AdamAntoshin/SAP-1.5/Schematics/WhatsApp Image 2019-12-20 at 13.47.41.jpeg

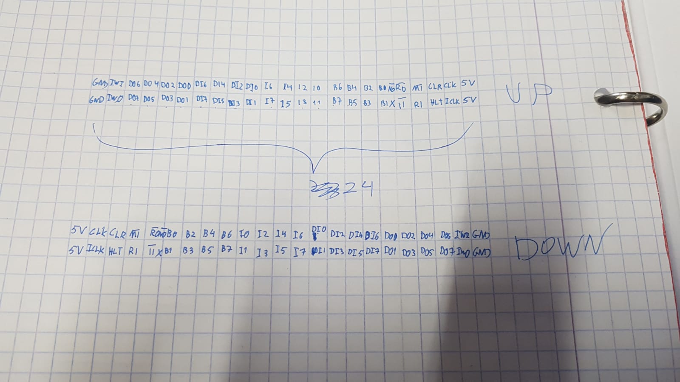
Schematics/WhatsApp Image 2019-12-20 at 13.47.41.jpeg
