AdamAntoshin/SAP-1.5/Documentation/Images/board1_back.jpeg

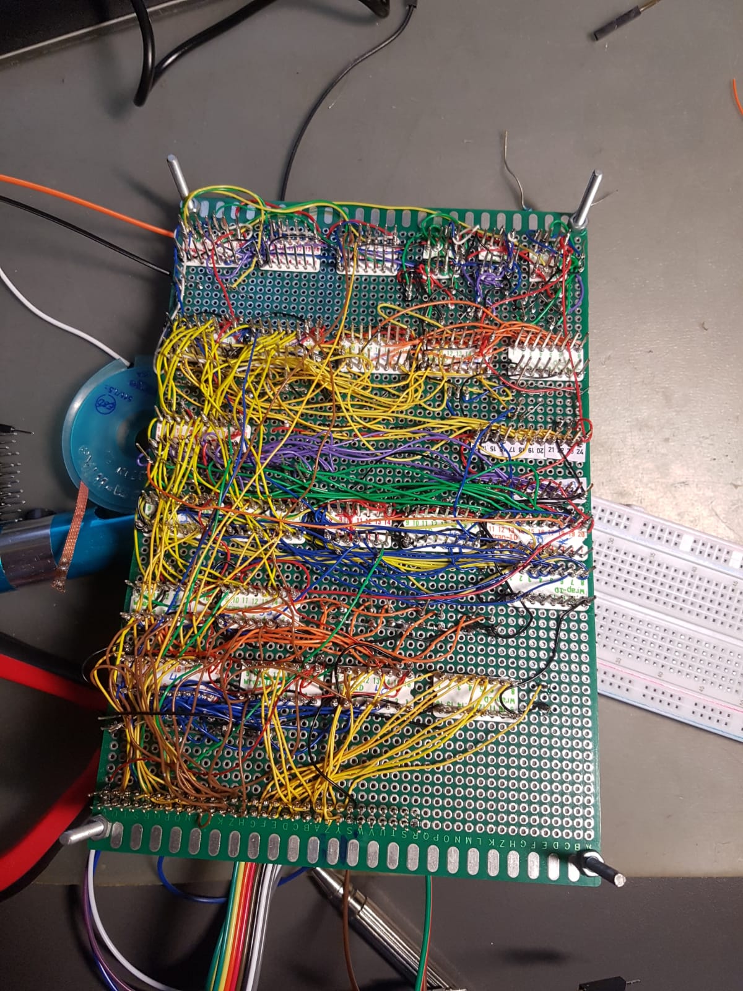
Documentation/Images/board1_back.jpeg
