AdamAntoshin/SAP-1.5/Documentation/Images/board1_front.jpeg

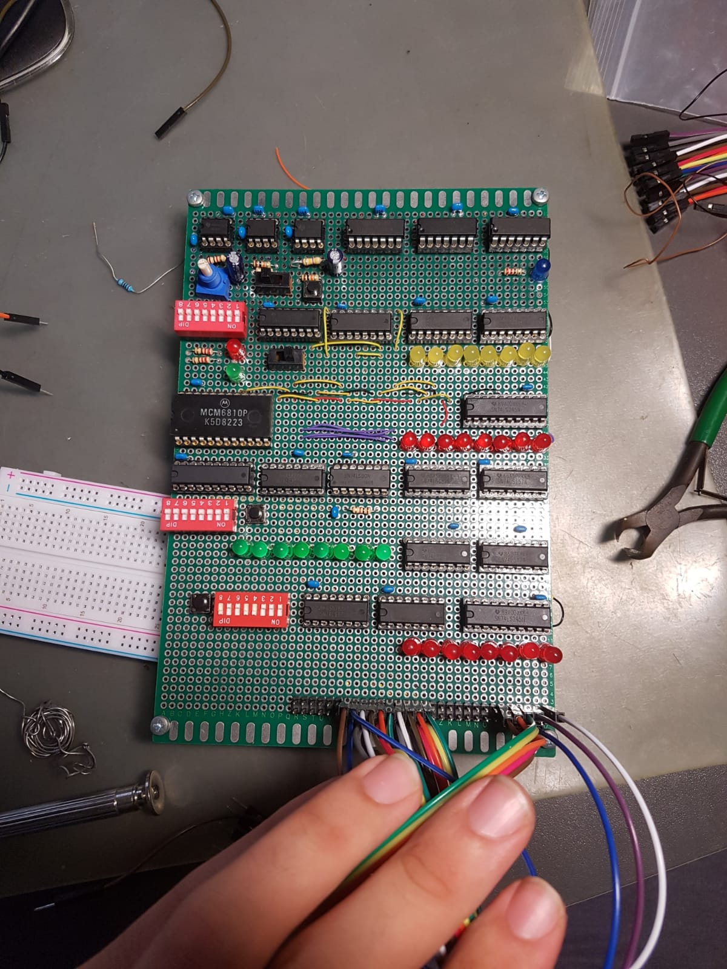
Documentation/Images/board1_front.jpeg
