AdamAntoshin/SAP-1.5/Documentation/Images/board2_back.jpeg

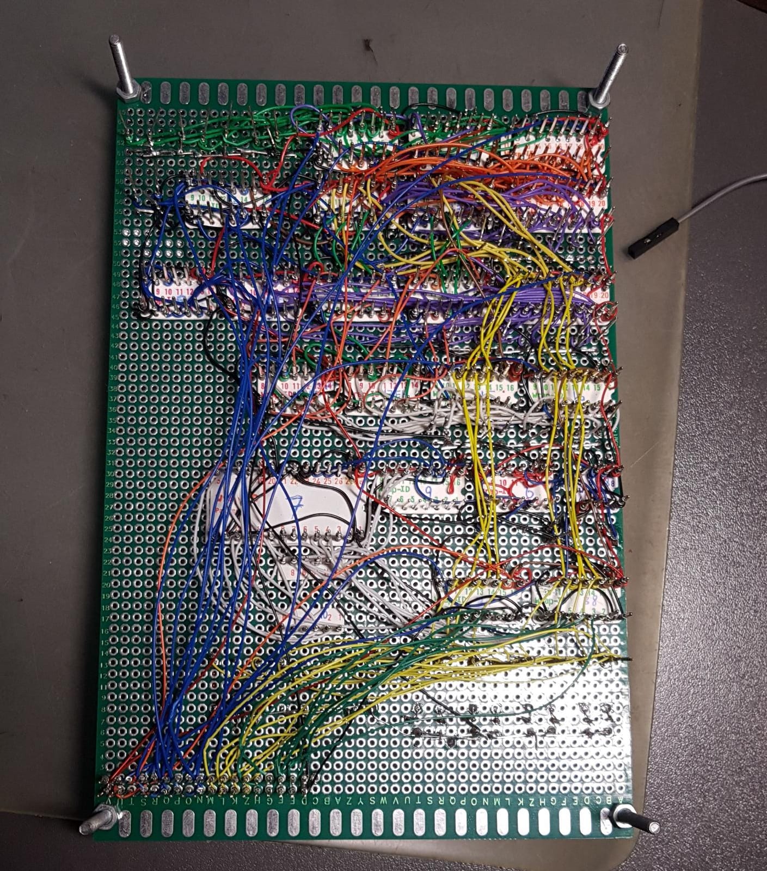
Documentation/Images/board2_back.jpeg
