AdamAntoshin/SAP-1.5/Documentation/Images/board2_front.jpeg

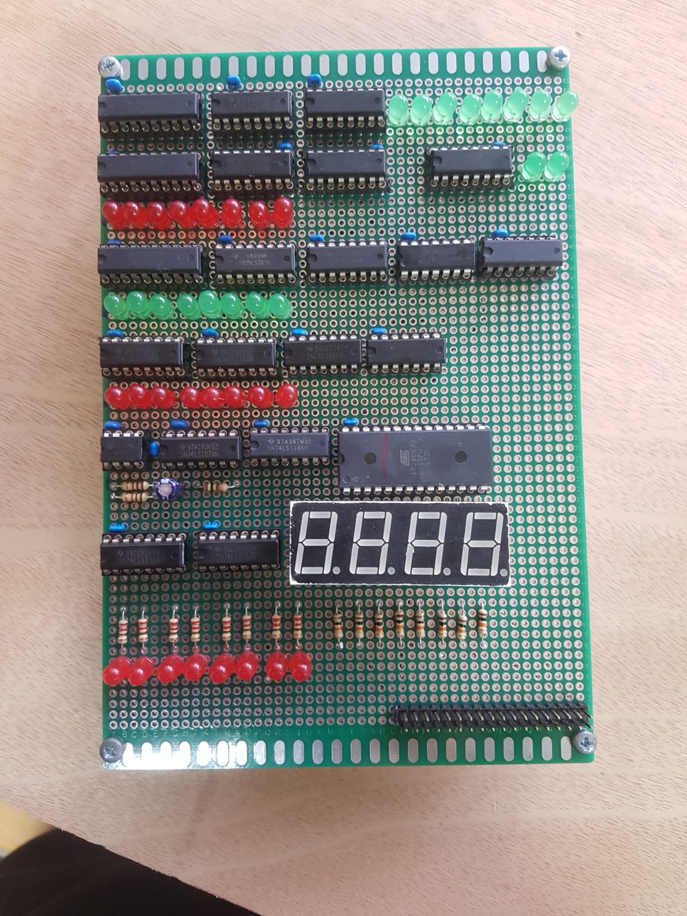
Documentation/Images/board2_front.jpeg
