AdamAntoshin/SAP-1.5/Documentation/Images/board3_back.jpeg

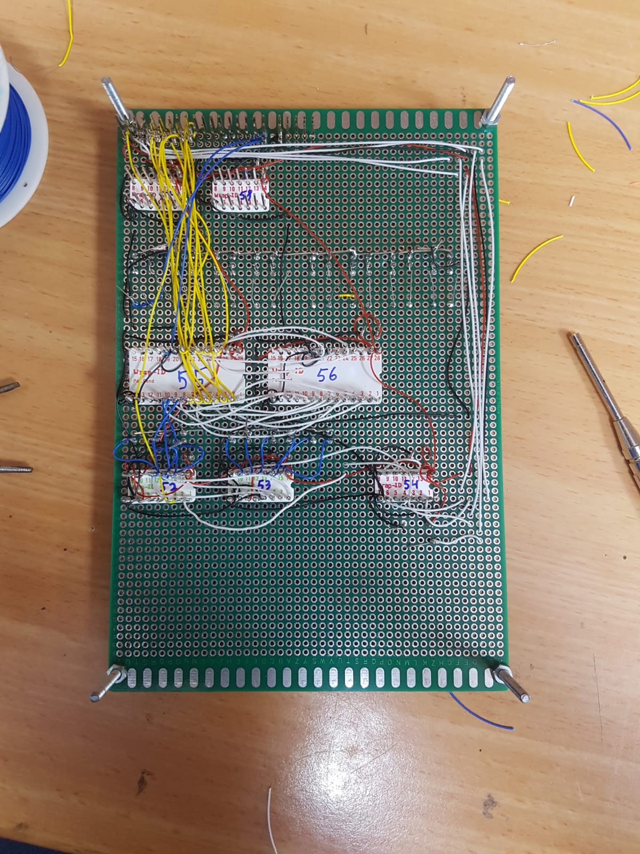
Documentation/Images/board3_back.jpeg
