AdamAntoshin/SAP-1.5/Documentation/Images/board3_front.jpeg

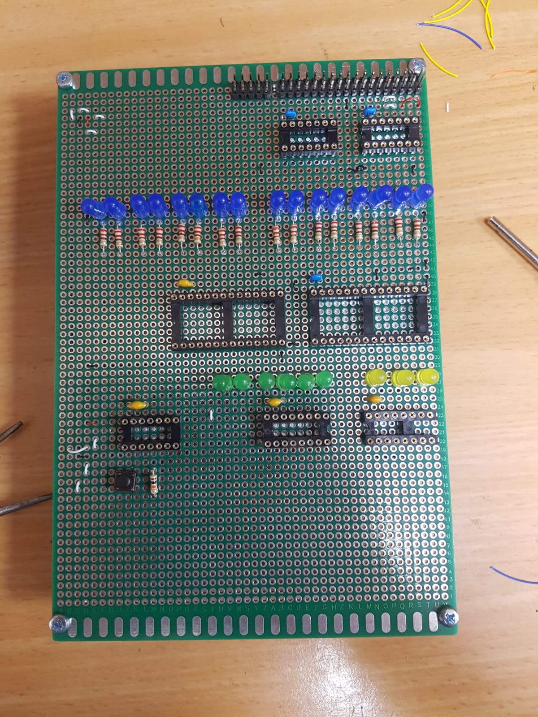
Documentation/Images/board3_front.jpeg
