AdamAntoshin/SAP-1.5/Schematics/EEPROM Programmer.pdf

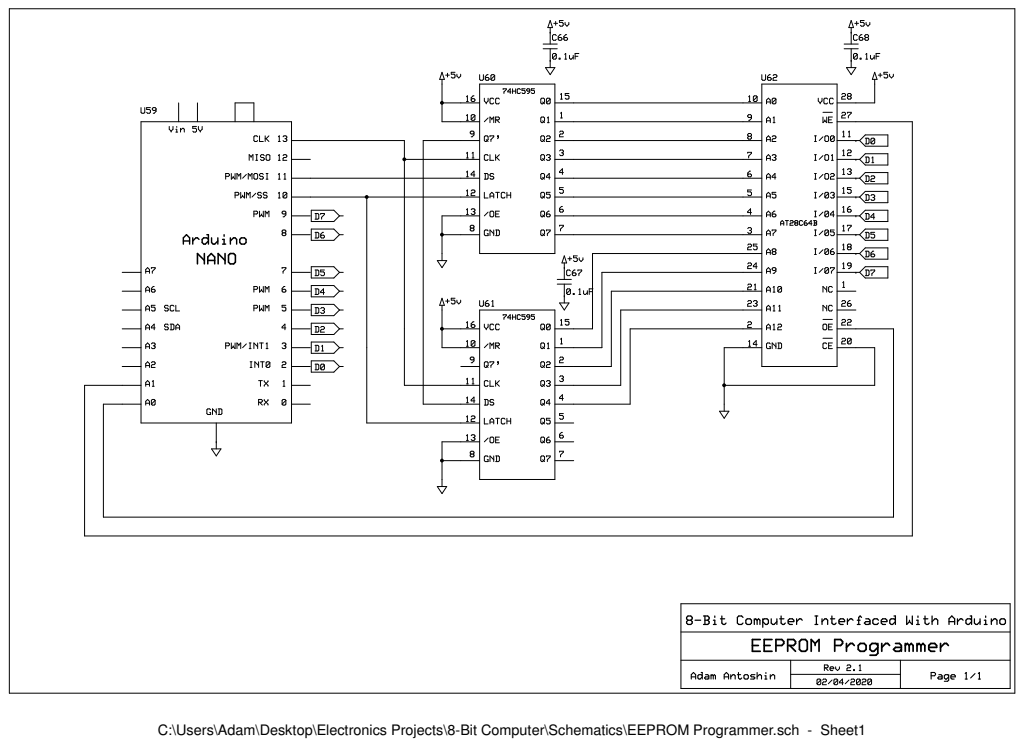
[picture p9: page 1]

C:\Users\Adam\Desktop\Electronics Projects\8-Bit Computer\Schematics\EEPROM Programmer.sch - Sheet1
