AdamAntoshin/SAP-1.5/Schematics/Arduino Driver.pdf

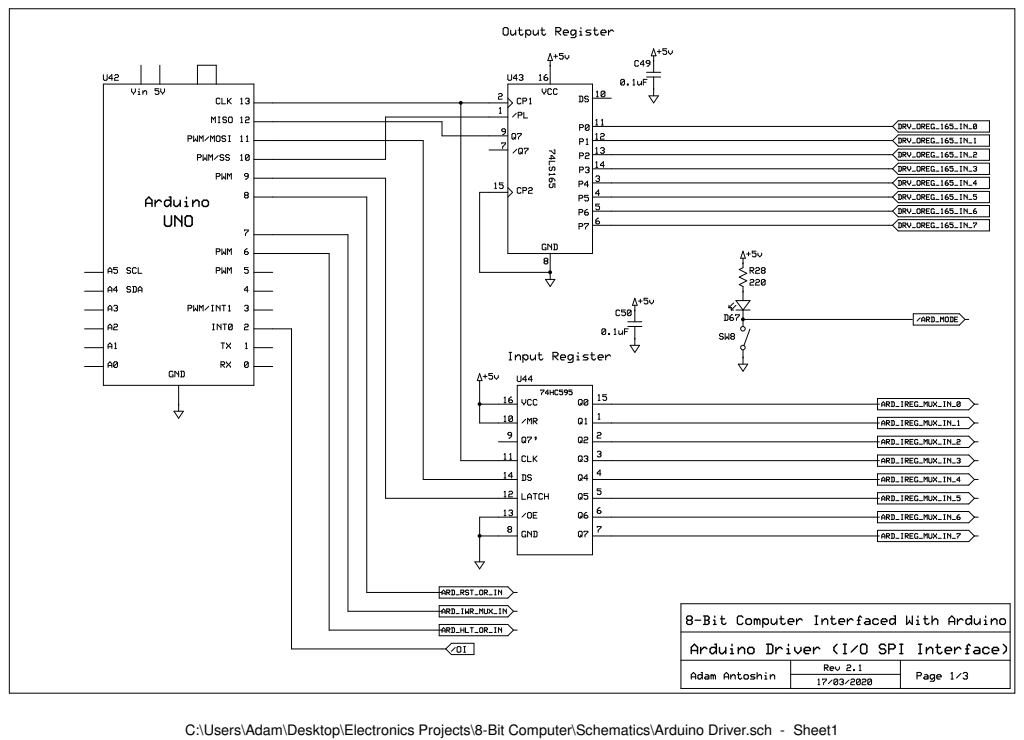
[picture p10: page 1]

C:\Users\Adam\Desktop\Electronics Projects\8-Bit Computer\Schematics\Arduino Driver.sch - Sheet1

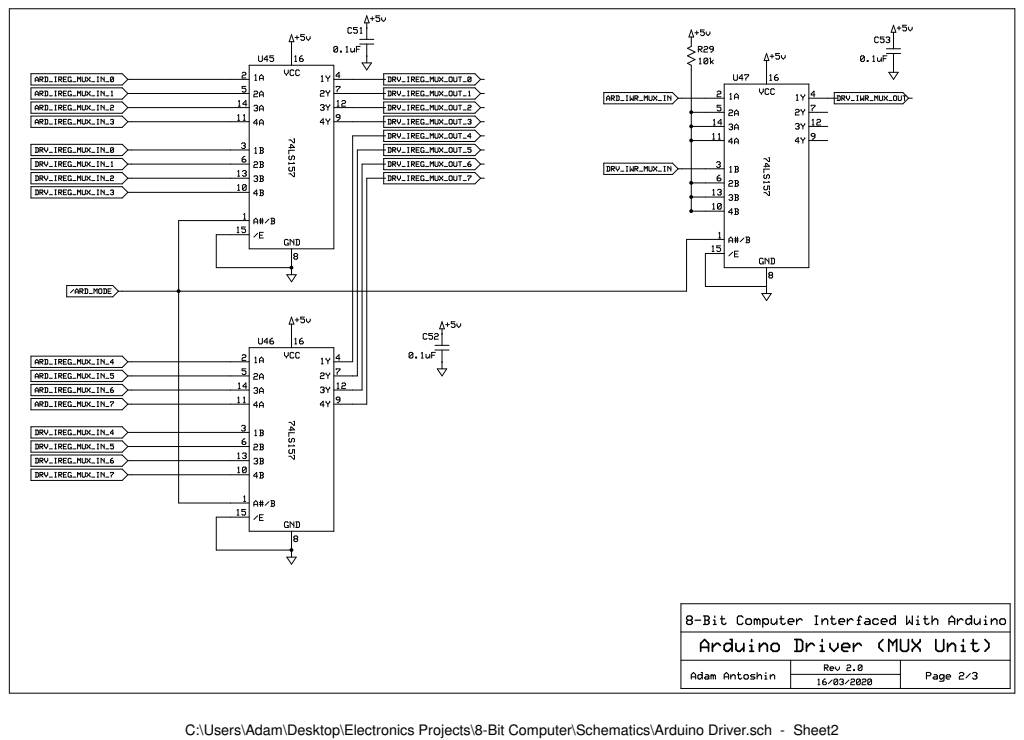
[picture p11: page 2]

C:\Users\Adam\Desktop\Electronics Projects\8-Bit Computer\Schematics\Arduino Driver.sch - Sheet2

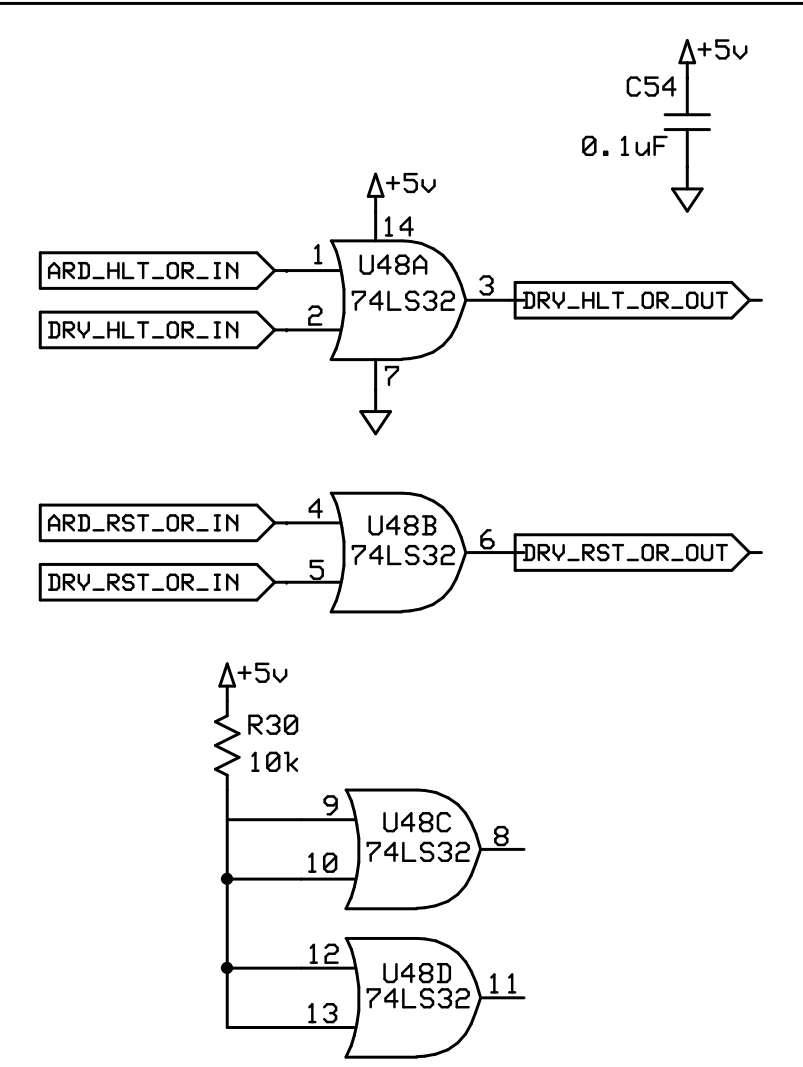
[picture p12: page 3]

C:\Users\Adam\Desktop\Electronics Projects\8-Bit Computer\Schematics\Arduino Driver.sch - Sheet3
