AdamAntoshin/SAP-1.5/Schematics/Ports.pdf

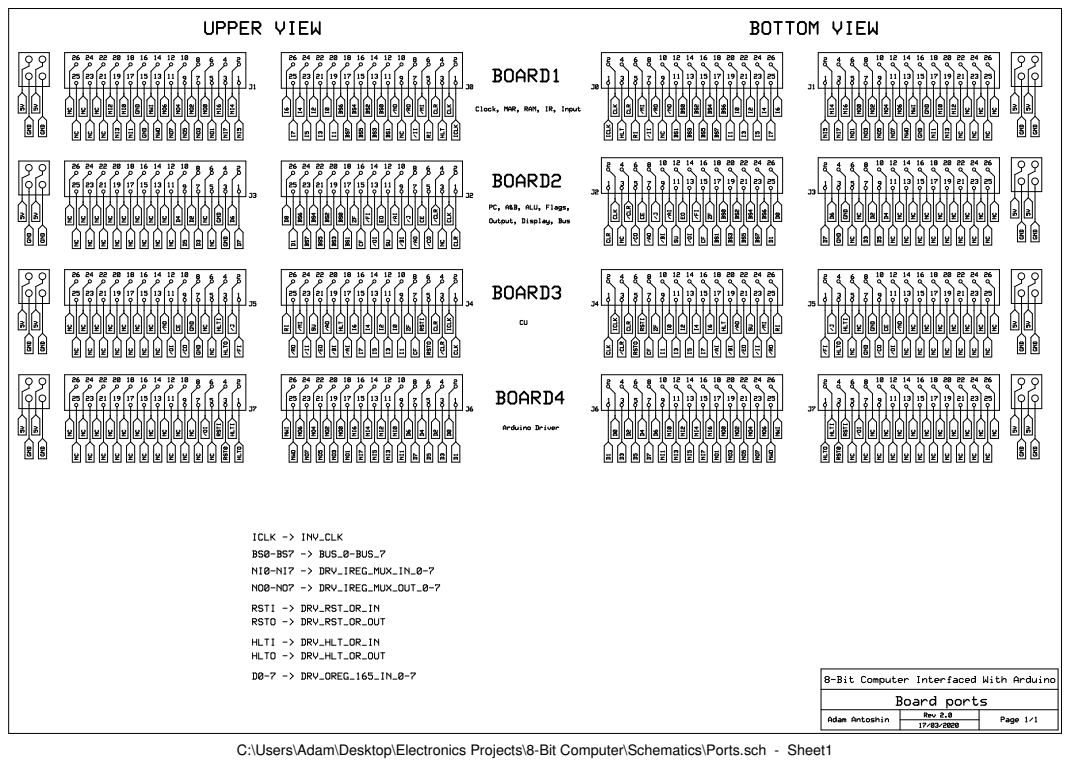
[picture p13: page 1]

C:\Users\Adam\Desktop\Electronics Projects\8-Bit Computer\Schematics\Ports.sch - Sheet1
