AdamAntoshin/SAP-1.5/Schematics/A Register.pdf

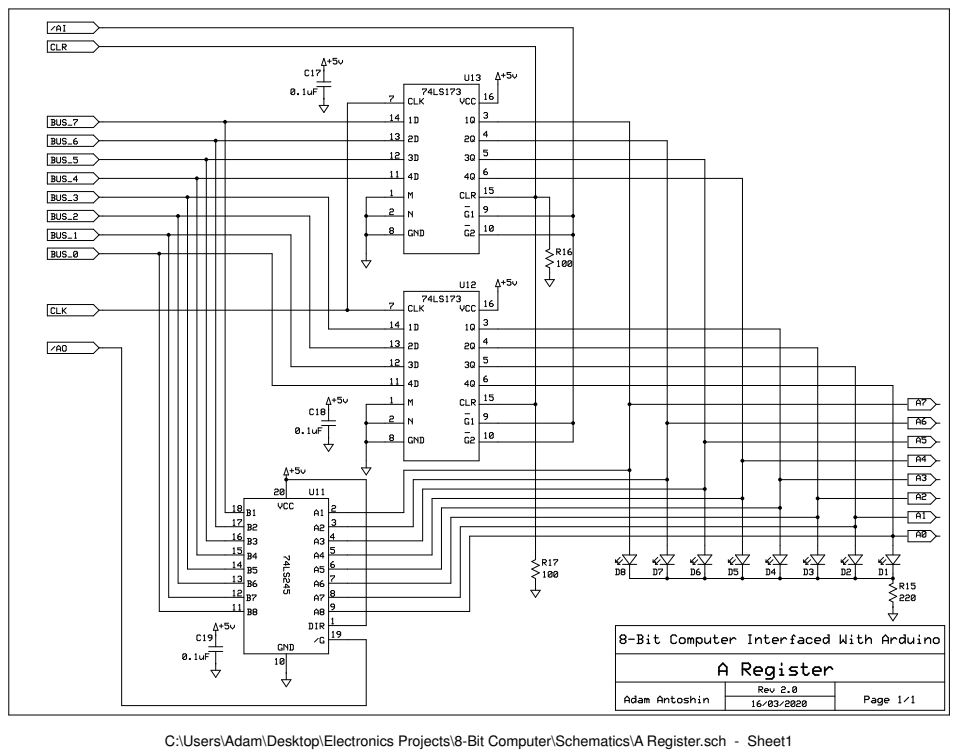
[picture p14: page 1]

C:\Users\Adam\Desktop\Electronics Projects\8-Bit Computer\Schematics\A Register.sch - Sheet1
