AdamAntoshin/SAP-1.5/Schematics/ALU.pdf

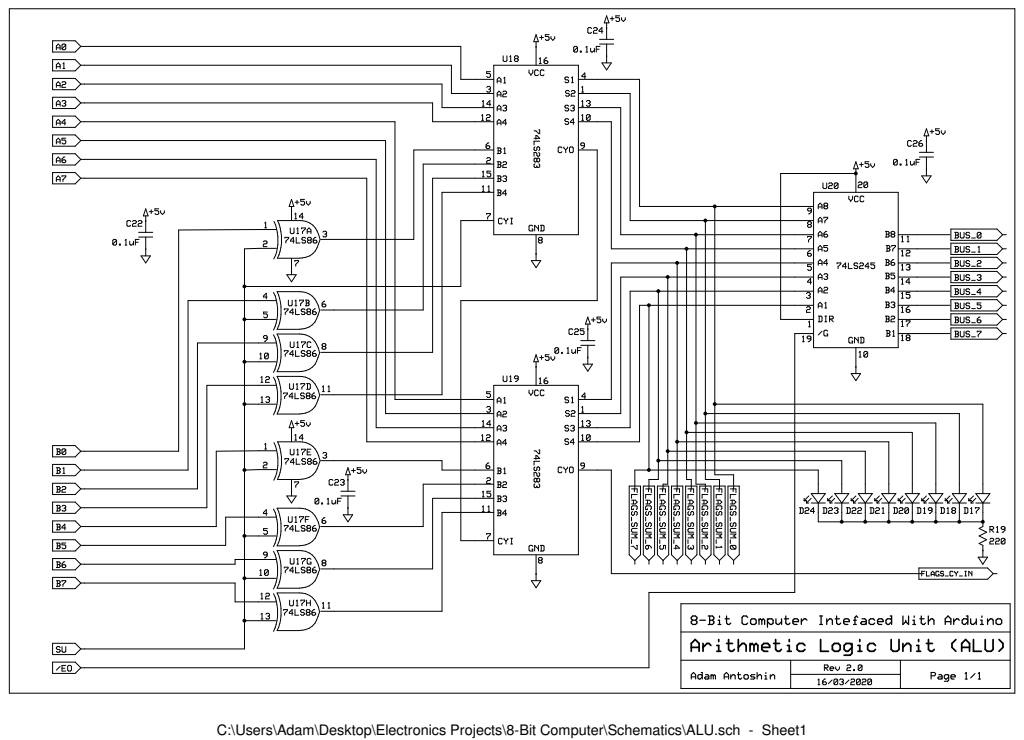
[picture p15: page 1]

C:\Users\Adam\Desktop\Electronics Projects\8-Bit Computer\Schematics\ALU.sch - Sheet1
