AdamAntoshin/SAP-1.5/Schematics/B Register.pdf

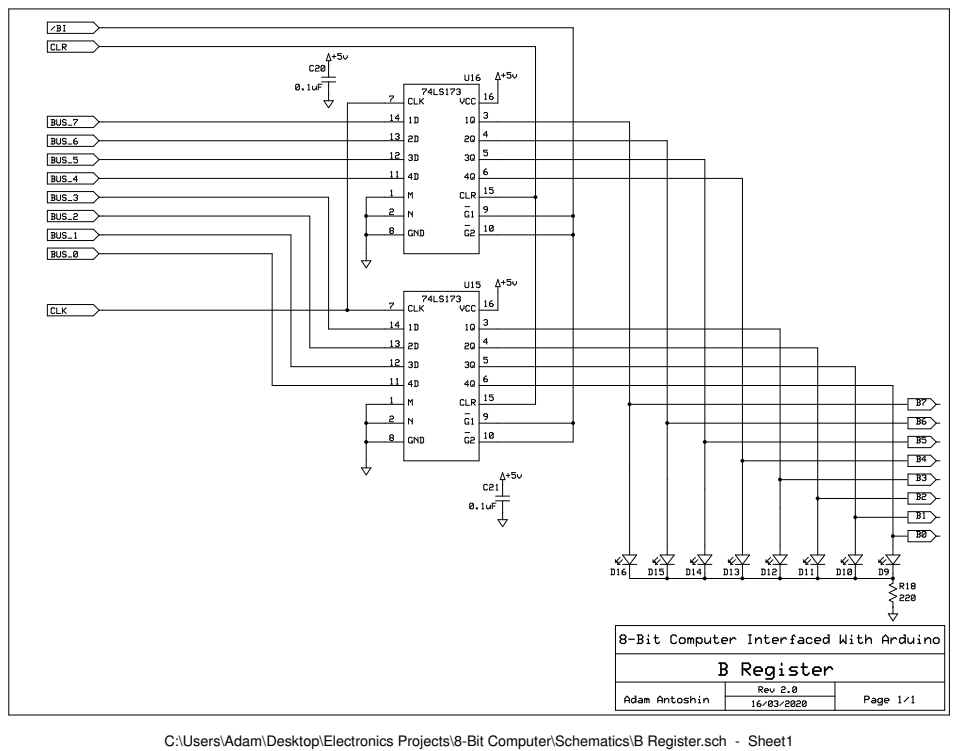
[picture p16: page 1]

C:\Users\Adam\Desktop\Electronics Projects\8-Bit Computer\Schematics\B Register.sch - Sheet1
