AdamAntoshin/SAP-1.5/Schematics/Clock.pdf

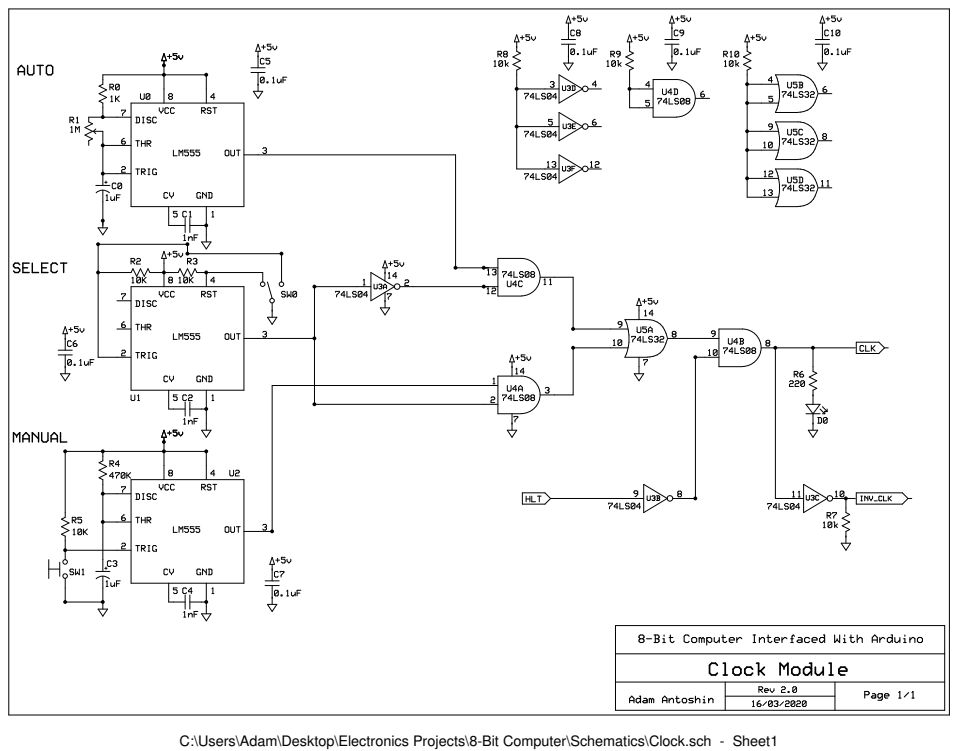
[picture p17: page 1]

C:\Users\Adam\Desktop\Electronics Projects\8-Bit Computer\Schematics\Clock.sch - Sheet1
