AdamAntoshin/SAP-1.5/Schematics/CU.pdf

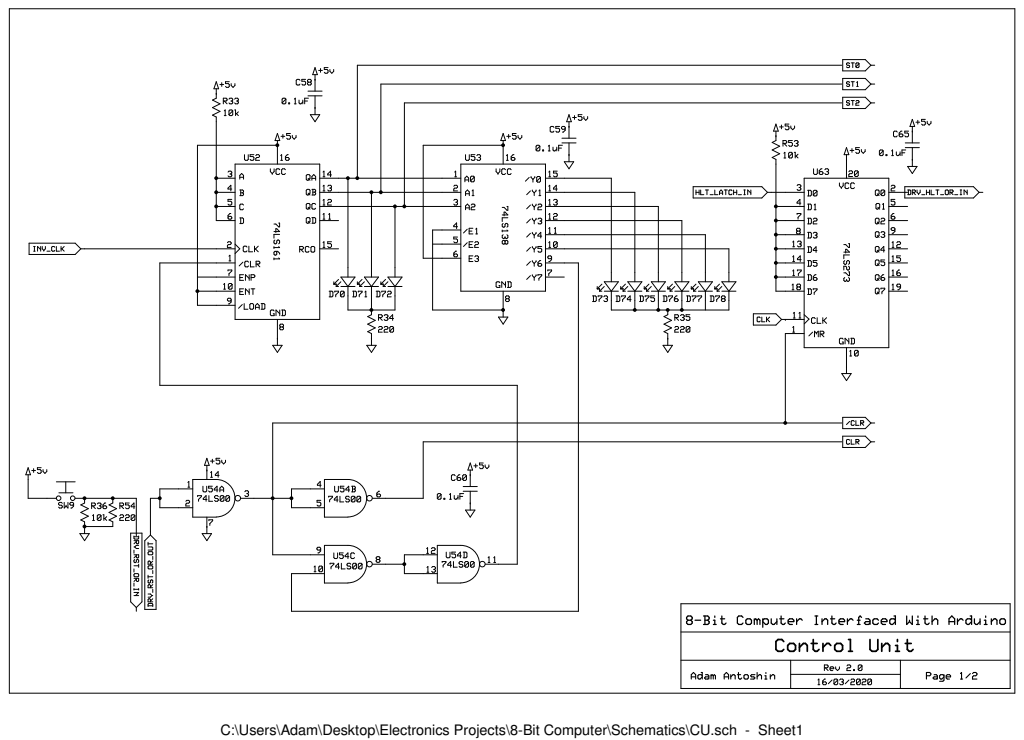
[picture p18: page 1]

C:\Users\Adam\Desktop\Electronics Projects\8-Bit Computer\Schematics\CU.sch - Sheet1

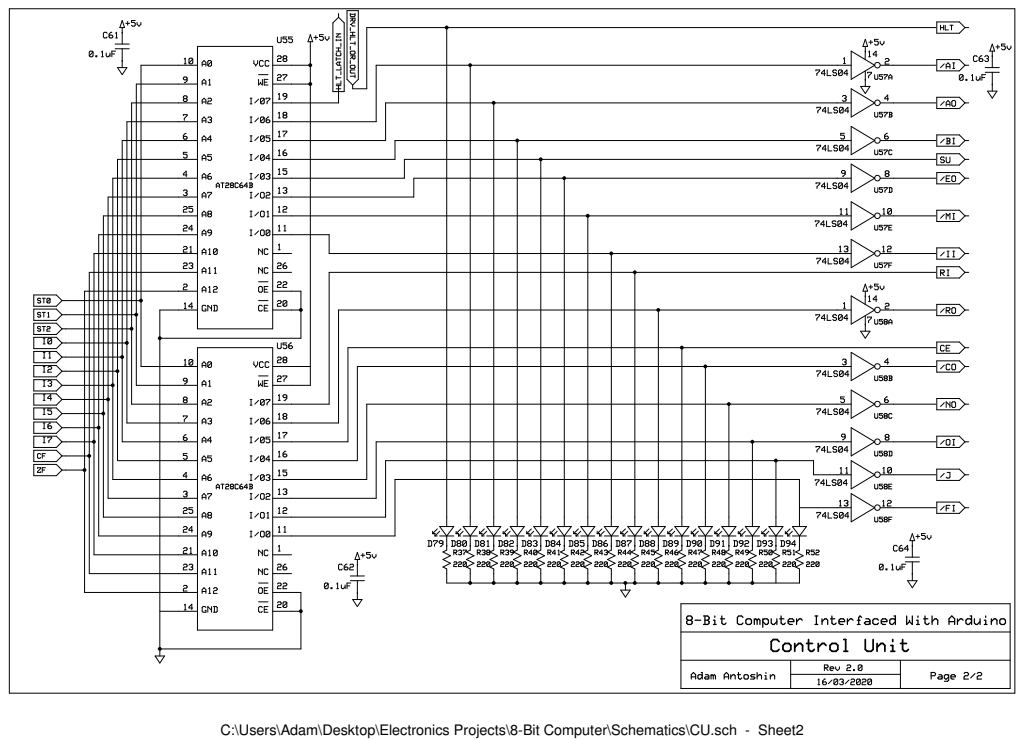
[picture p19: page 2]

C:\Users\Adam\Desktop\Electronics Projects\8-Bit Computer\Schematics\CU.sch - Sheet2
