AdamAntoshin/SAP-1.5/Schematics/Display.pdf

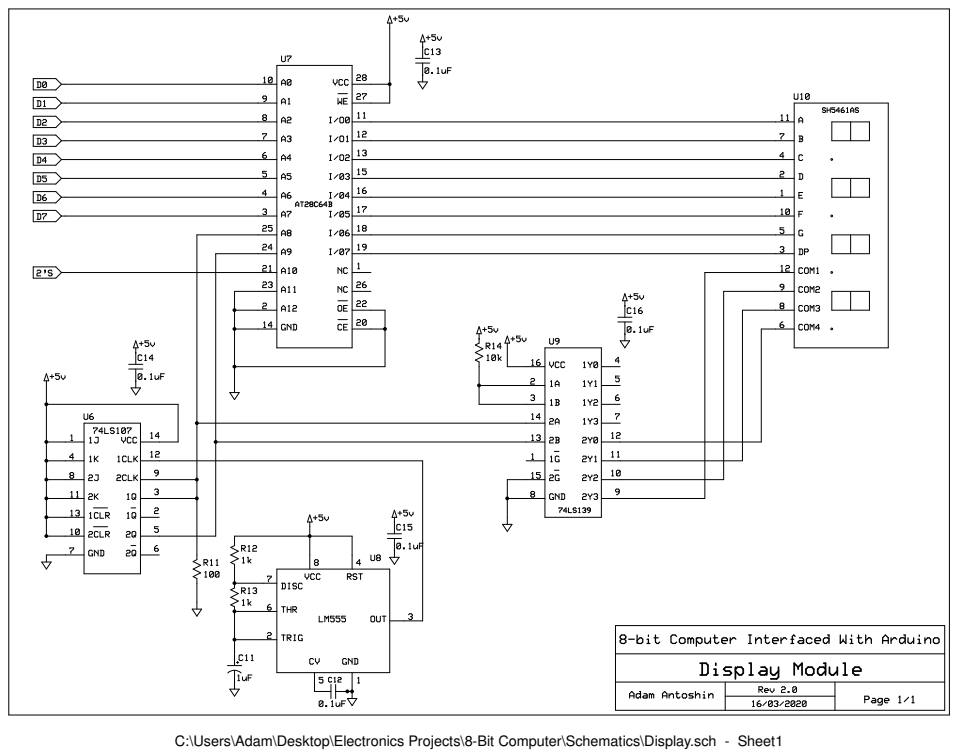
[picture p20: page 1]

C:\Users\Adam\Desktop\Electronics Projects\8-Bit Computer\Schematics\Display.sch - Sheet1
