AdamAntoshin/SAP-1.5/Schematics/Flags.pdf

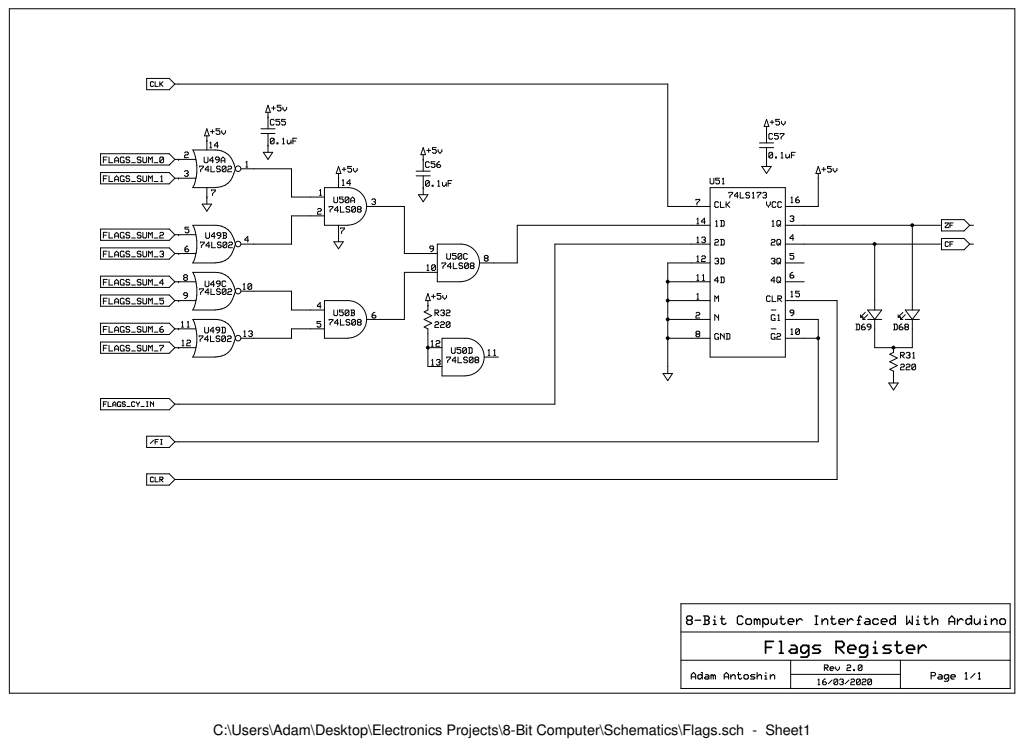
[picture p21: page 1]

C:\Users\Adam\Desktop\Electronics Projects\8-Bit Computer\Schematics\Flags.sch - Sheet1
