AdamAntoshin/SAP-1.5/Schematics/Input.pdf

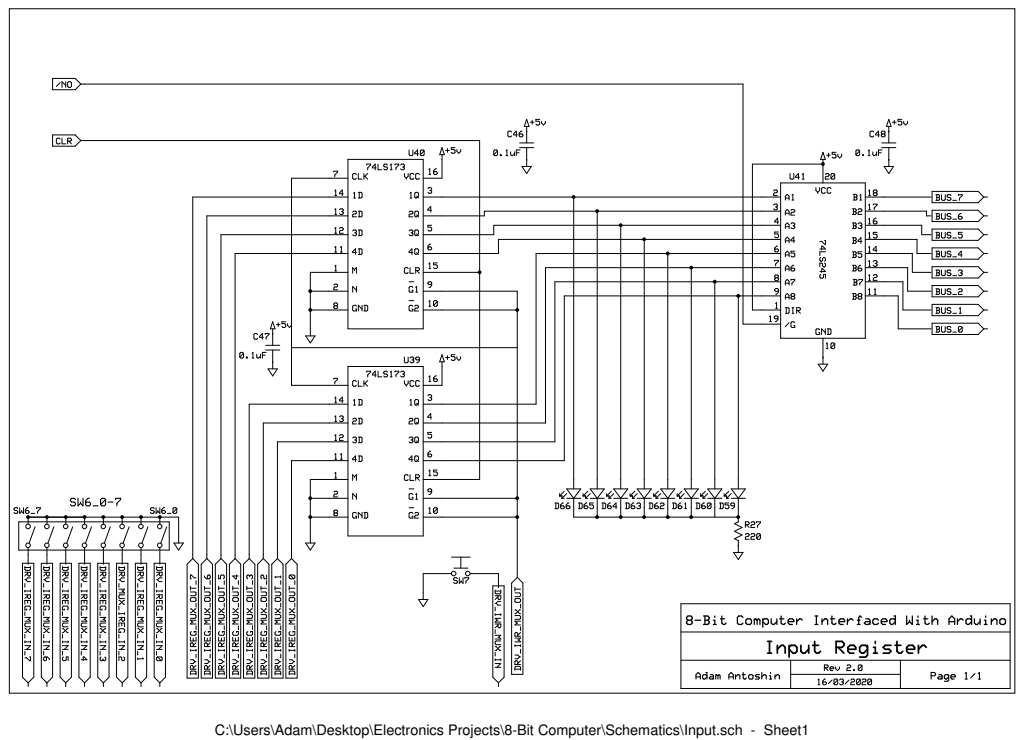
[picture p22: page 1]

C:\Users\Adam\Desktop\Electronics Projects\8-Bit Computer\Schematics\Input.sch - Sheet1
