AdamAntoshin/SAP-1.5/Schematics/IR (No IO).pdf

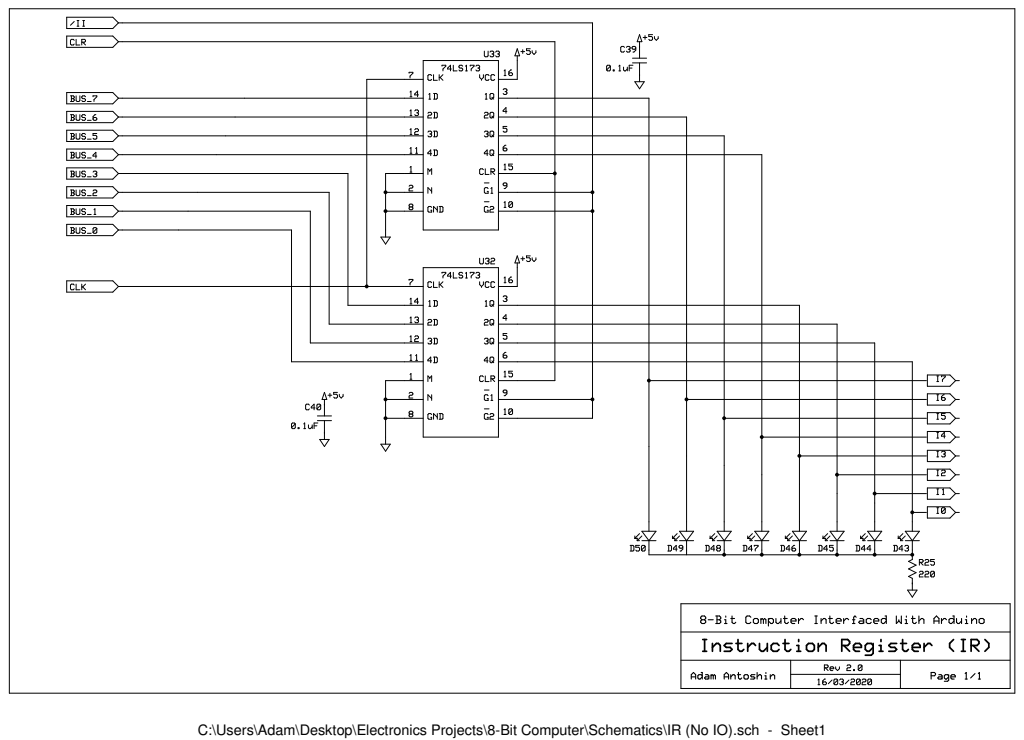
[picture p23: page 1]

C:\Users\Adam\Desktop\Electronics Projects\8-Bit Computer\Schematics\IR (No IO).sch - Sheet1
