AdamAntoshin/SAP-1.5/Schematics/MAR.pdf

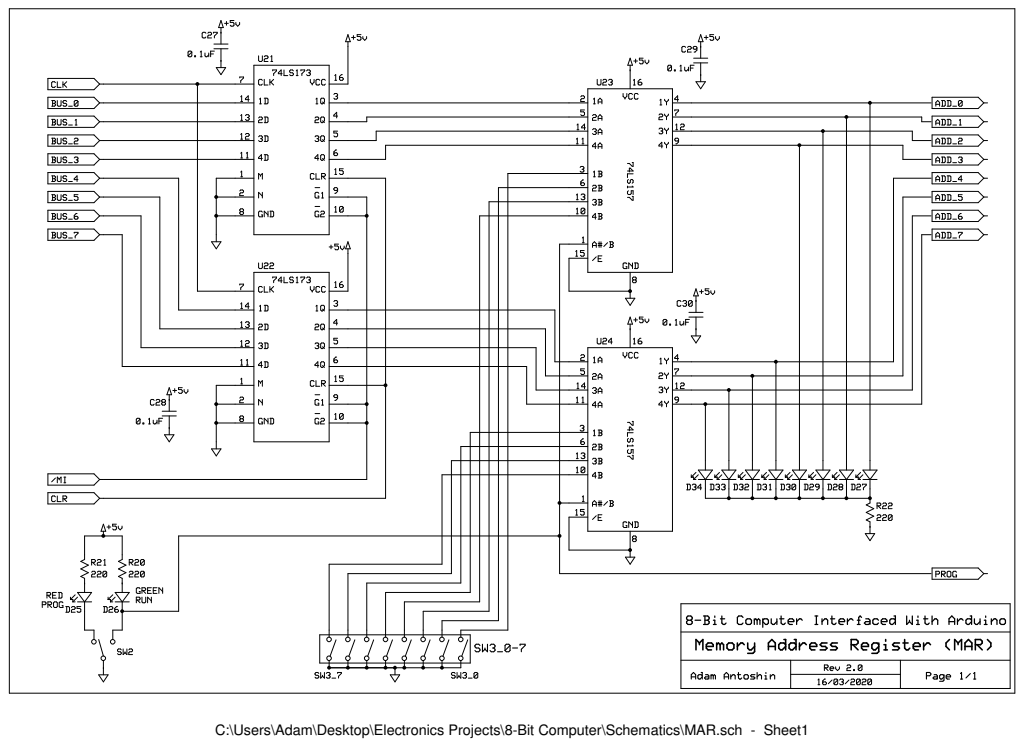
[picture p24: page 1]

C:\Users\Adam\Desktop\Electronics Projects\8-Bit Computer\Schematics\MAR.sch - Sheet1
