AdamAntoshin/SAP-1.5/Schematics/Output.pdf

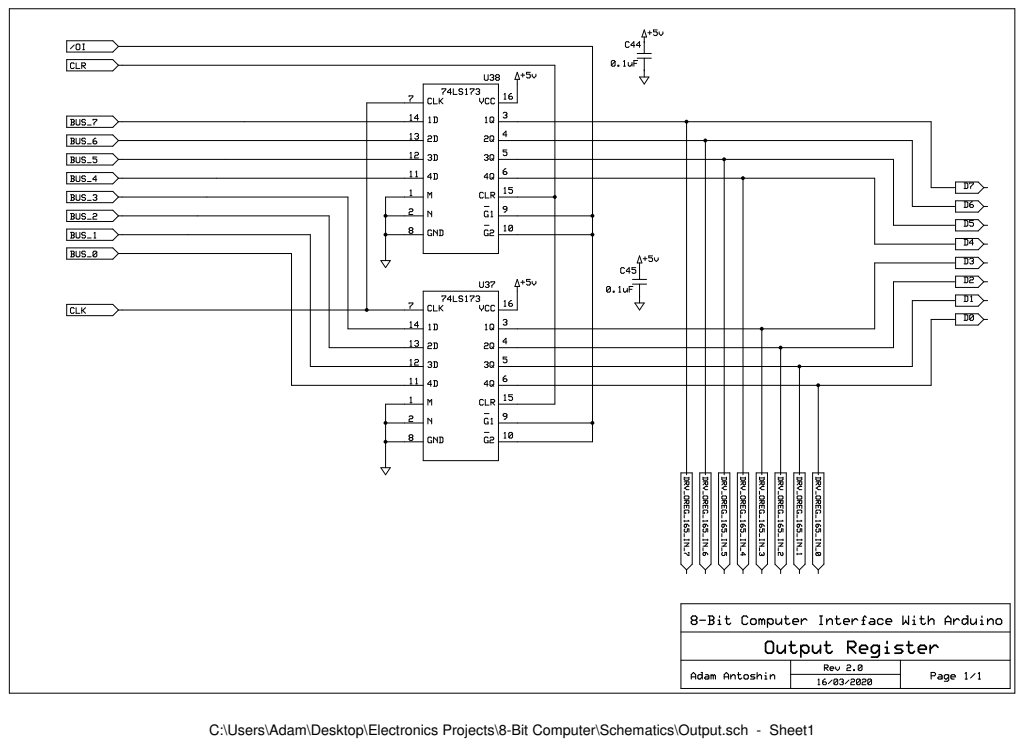
[picture p25: page 1]

C:\Users\Adam\Desktop\Electronics Projects\8-Bit Computer\Schematics\Output.sch - Sheet1
