AdamAntoshin/SAP-1.5/Schematics/Overview.pdf

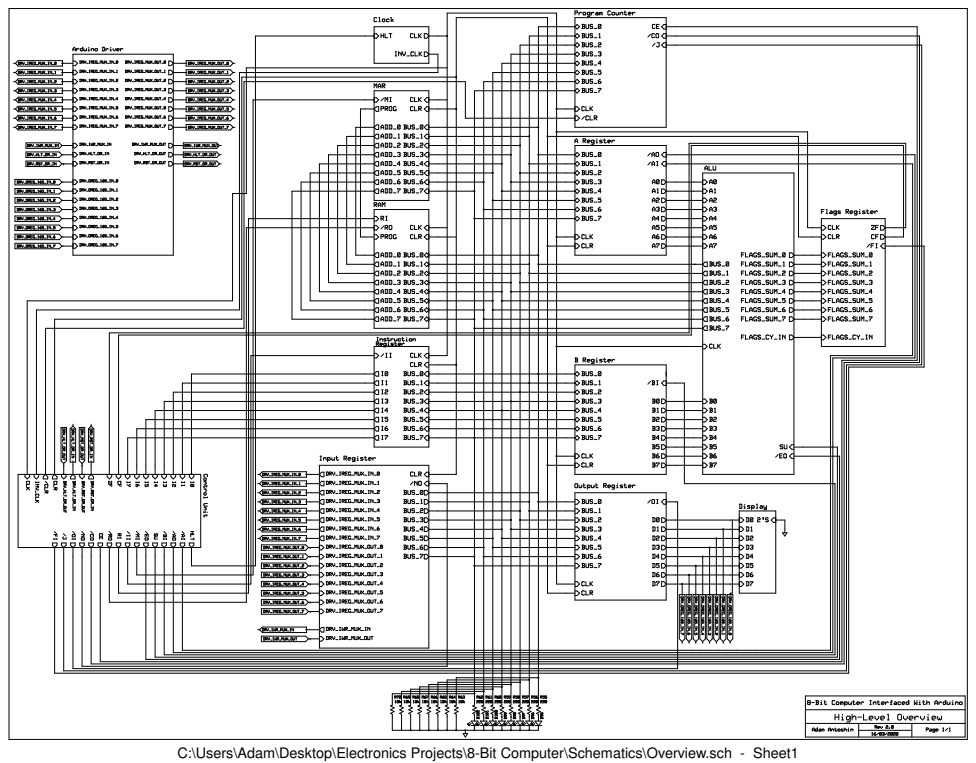
[picture p26: page 1]

C:\Users\Adam\Desktop\Electronics Projects\8-Bit Computer\Schematics\Overview.sch - Sheet1
