AdamAntoshin/SAP-1.5/Schematics/PC.pdf

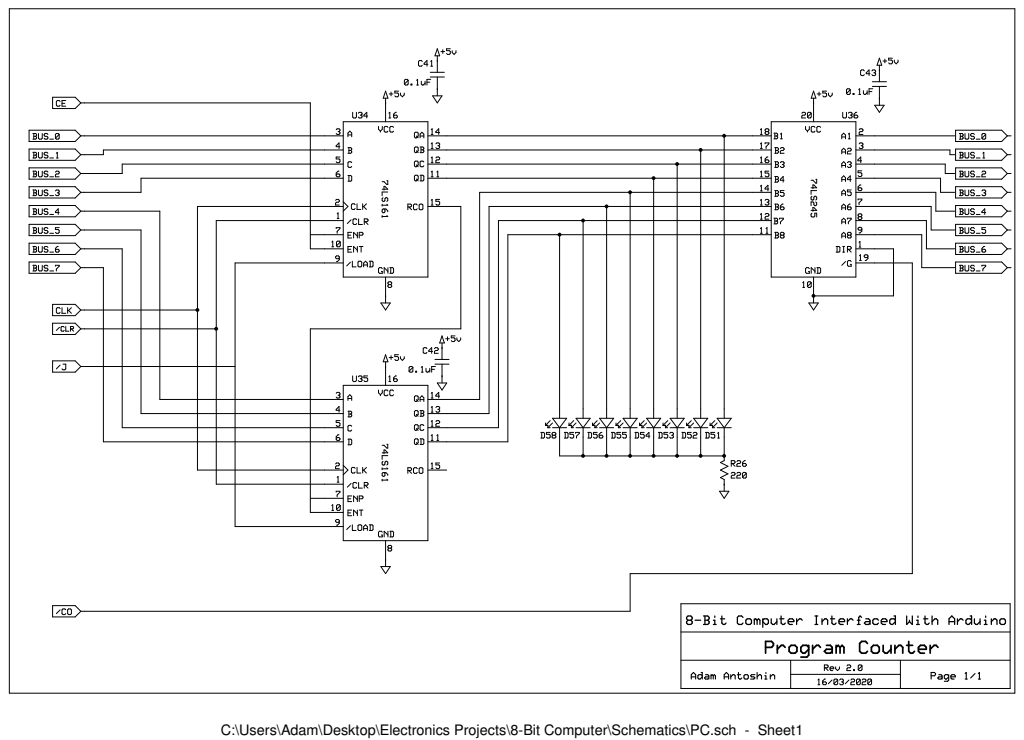
[picture p27: page 1]

C:\Users\Adam\Desktop\Electronics Projects\8-Bit Computer\Schematics\PC.sch - Sheet1
