AdamAntoshin/SAP-1.5/Schematics/RAM.pdf

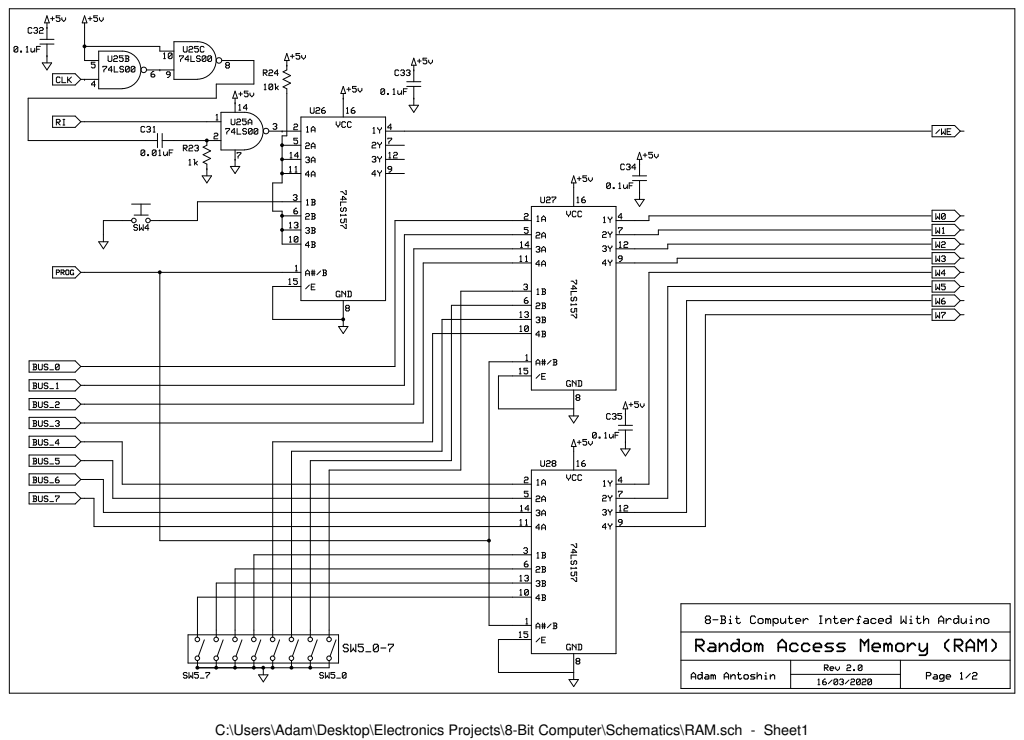
[picture p28: page 1]

C:\Users\Adam\Desktop\Electronics Projects\8-Bit Computer\Schematics\RAM.sch - Sheet1

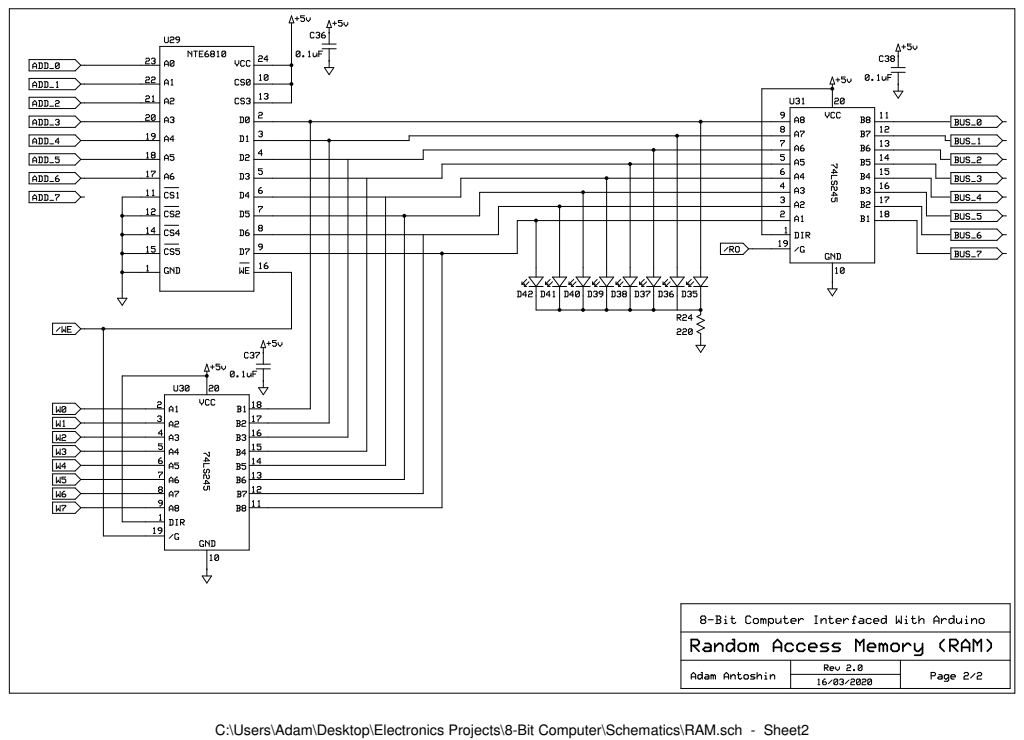
[picture p29: page 2]

C:\Users\Adam\Desktop\Electronics Projects\8-Bit Computer\Schematics\RAM.sch - Sheet2
