AdamAntoshin/SAP-1.5/Schematics/IR.pdf

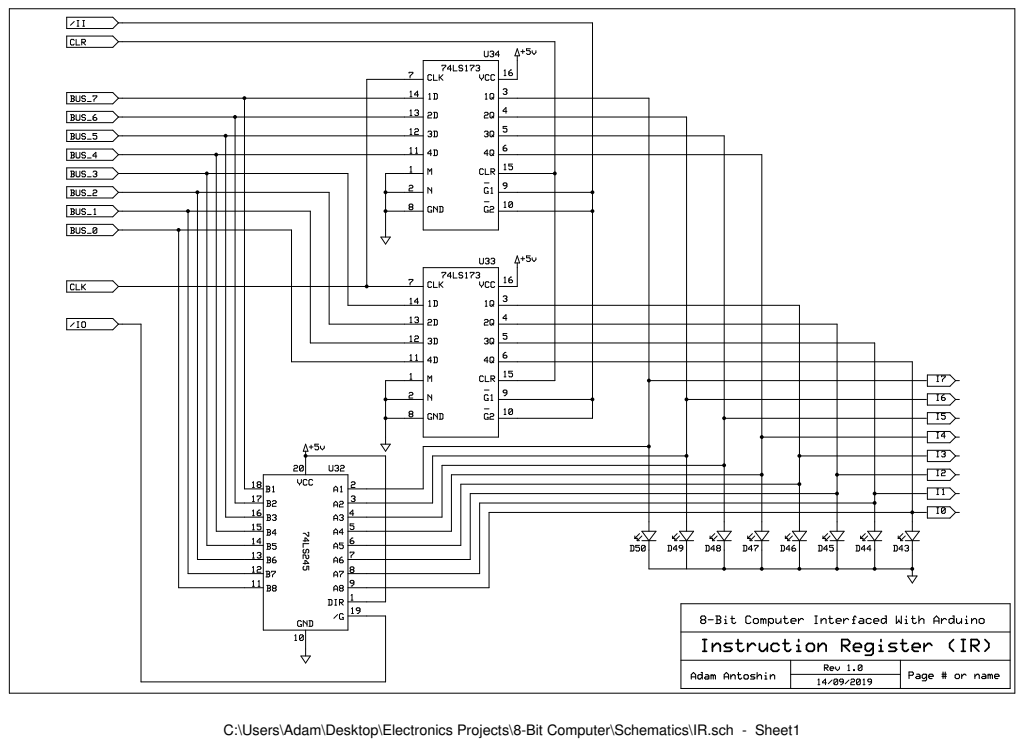
[picture p30: page 1]

C:\Users\Adam\Desktop\Electronics Projects\8-Bit Computer\Schematics\IR.sch - Sheet1
