AdamAntoshin/SAP-1.5/(commit log)

2020-01-02 Create schematics folder
2020-01-02 Upload Arduino programs
2020-01-06 Update board images - 06/01/2020 (morning)
2020-01-06 Update board-2 images
2020-01-08 Update board images (08/01/20)
2020-01-14 Update B register schematic
    [B Register.sch]
2020-01-14 Update overview schematic
    [Overview.sch]
2020-01-15 update board 2
2020-01-16 Update board 2 images
2020-01-22 Add board 3 images (CU)
2020-01-30 Update board 3 images
2020-03-16 Major schematic revision
    [A Register.sch, ALU.sch, Arduino Driver.sch, B Register.sch, CU.sch, Clock.sch, Display.sch, EEPROM Programmer.sch]
2020-03-17 schematic update
    [Arduino Driver.sch, Ports.sch]
